AnastasiaMelnic/Rauch-Filter-and-PGA-Signal-Conditioning-Interface/Raport Proiect Practic CAIF.pdf

# Proiect CAIF

Tema: | Proiectarea unei interfețe analogice, formată dintr-un filtru Rauch trece – bandă de ordinul 2 și un amplificator programabil, în baza specificațiilor și topologiilor date
Student: | Melnic Anastasia

## 1. Specificații generale :

### 1.1 Schema bloc

În Figura 1 este reprezentată schema bloc a interfeței analogice proiectate.

Interfața analogică este un sistem care permite comunicarea între un dispozitiv digital (de ex. microcontroler) și lumea analogică (de ex. senzori). Aceasta:

- Primește sau transmite semnalele analogice;
- Le condiționează (filtrează, amplifică);
- Le pregătește pentru conversia în digital (printr-un ADC) sau invers (prin DAC);

Rolul elementelor din schema bloc (Figura 1):

- Senzorul măsoară o mărime fizică și o transformă într-un semnal electric analogic(tensiune).
- Filtrul trece-bandă elimină zgomotul și frecvențele nedorite din semnalul primit de la senzor. Păstrează o bandă specifică de frecvențe.
- Amplificatorul programabil amplifică semnalul analogic la un nivel optim pentru ADC, pentru a utiliza întreaga gamă a ADC-ului și a asigura o precizie mare a conversiei.
- ADC-ul convertește semnalul analogic, filtrat și amplificat, într-o valoare digitală.
Sensor | Rauch
BPF | PGA | ADC

Figura 1 Schema bloc

### 1.2 Specificații Etaj 1 (Filtru)

Tip funcție de transfer | Topologie | Câștigul linear în banda de trecere |H0| | Rintrare minim | Q | BW | Liniaritate
Trece-bandă | Rauch | 1 | 1 kΩ | 0.707 | 1 kHz | Amplitudinea de la ieșire = (amplitudinea Amplitudinea de iesire = (amplitudinea de de la intrare) * (câstigul în banda de trecere) pentru un semnal armonic cu frecvența = frecvența centrală

### 1.3 Specificații Etaj 2 (PGA)

Tip PGA | Castig minim | Rezolutie | Numar pasi | Castig maxim | Rin minim | Banda
Inversor, switch-uri in calea de semnal, conexiune serie | 8 dB | 3dB | 4 | 17 dB | 1 kΩ | Mai mare decat banda filtrului

Tabel 1 Specificații Etaj 1 (Filtru)

Tabel 2 Specificații Etaj 2 (PGA)

## 2. Dimensionarea circuitului

### 2.1 Dimensionare FTB Rauch

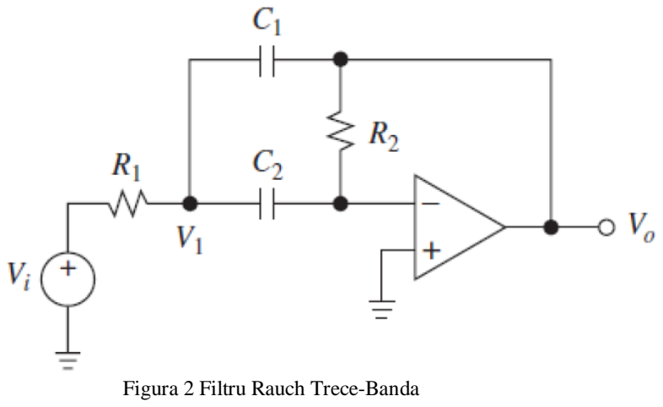
[picture p1: figure]
Figura 2 Filtru Rauch Trece-Banda

Formula funcției de transfer a filtrului este:

H(s) =

H0 ∙

ω0
Q
- s

s

2 +

ω0
Q
- s+ ω0

2

(1)

Pulsația centrală este:

ω0 =

1
√R1R2C1C2

(2)

Factorul de calitate este:

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
Câstigul la frecvența centrală este:

H0 =

−

R2
R1
1+

C1
C2

(4)

Consider C1=C2=C. Formulele (2), (3), (4) devin:

ω0 =

1
C ∙ √R1R2

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
H0 = −

R2
2R1

(7)

În formula (7), semnul “-“ din fața raportului indică faptul că semnalul de ieșire e în antifază față de semnalul de intrare. În continuare, pentru dimensionarea filtrului voi volosi |H0|.

Ținând cont că frecvența centrală f0 este:

f0 = BW ∙ Q | (8)

am determinat expresiile pentru dimensionarea rezistențelor:

R1 =

1
C

∙

1
2π ∙|H0

|∙BW

| (9)

R2 =

1
C

∙

1
π ∙BW | (10)

Pentru C=65 nF, am obținut R1=2448 Ω si R2=4897 Ω.
Am folosit în circuit amplificatorul operațional LT1357, pe care l-am alimentat cu ±5 V.

În Figura 3 e reprezentat circuitul in LTspice:

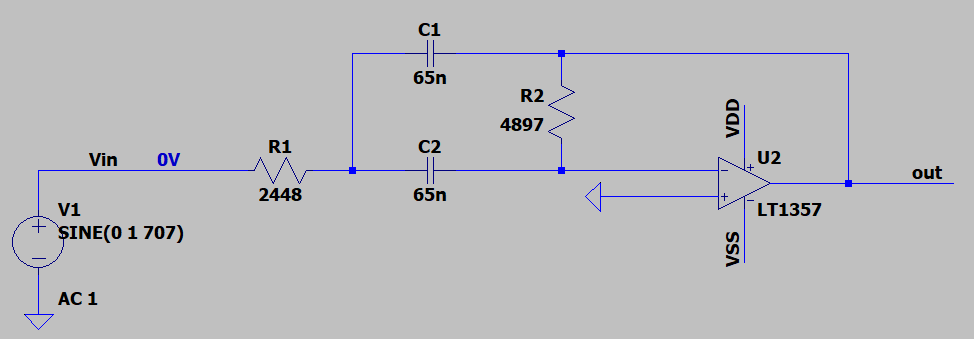
[picture p2: figure]

Pentru a asigura o implementare corectă a circuitului pe breadboard, am măsurat cu multimetrul valorile exacte ale rezistențelor. Capacitatea condensatorului am

Figura 3 Filtru Rauch Trece-Banda dimensionat determinat-o experimental, cu ajutorul unui filtru RC, și am observat că, deși condensatorul este marcat ca având o valoare nominală de 100nF, capacitatea efectivă masurată este de aproximativ 65nF, ceea ce indică o toleranță mare a componentelor.

Pentru a obține R1≈2.45kΩ, am conectat în serie 3 rezistențe de 2.2kΩ, 220Ω și 33Ω, iar pentru R2≈4.9kΩ, am conectat în serie 1 rezistență de 4.7 kΩ și 2 rezistențe de câte 150 Ω. Am folosit 2 condensatoare cu capacitatea nominală de 100nF (valoarea masurată este 65nF).
În Figura 4 este reprezentat montajul pe breadboard:

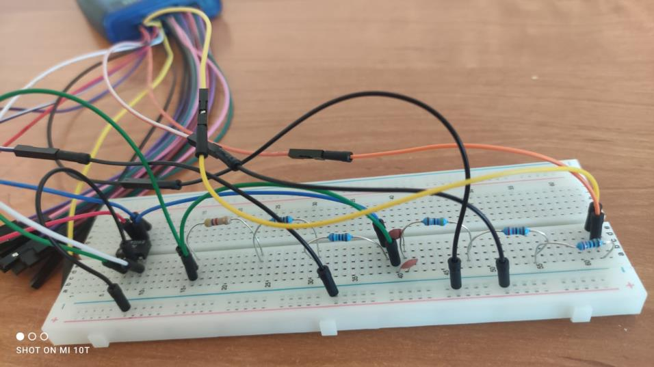
[picture p3: figure]

### 2.3 Dimensionare PGA

Conform specificatiilor, |Av| = {8dB, 11dB, 14dB, 17dB} = {2.51V/V, 3.54V/V, 5.01V/V, 7.07V/V}. Am dimensionat PGA-ul in baza formulelor:
|AV1| =

RF1
RG

= 2.51

|AV2| =

RF1 + RF2
RG

= 3.54

|AV3| =

RF1 + RF2 + RF3
RG

= 5.01

|AV4| =

RF1 + RF2 + RF3 + RF4
RG

= 7.07

Figura 4 Filtru Rauch Trece-Banda, montaj experimental

Am ales RG=1016Ω si am determinat RF1=2554Ω, RF2=1056Ω, RF3=1498Ω si RF4=2128Ω.

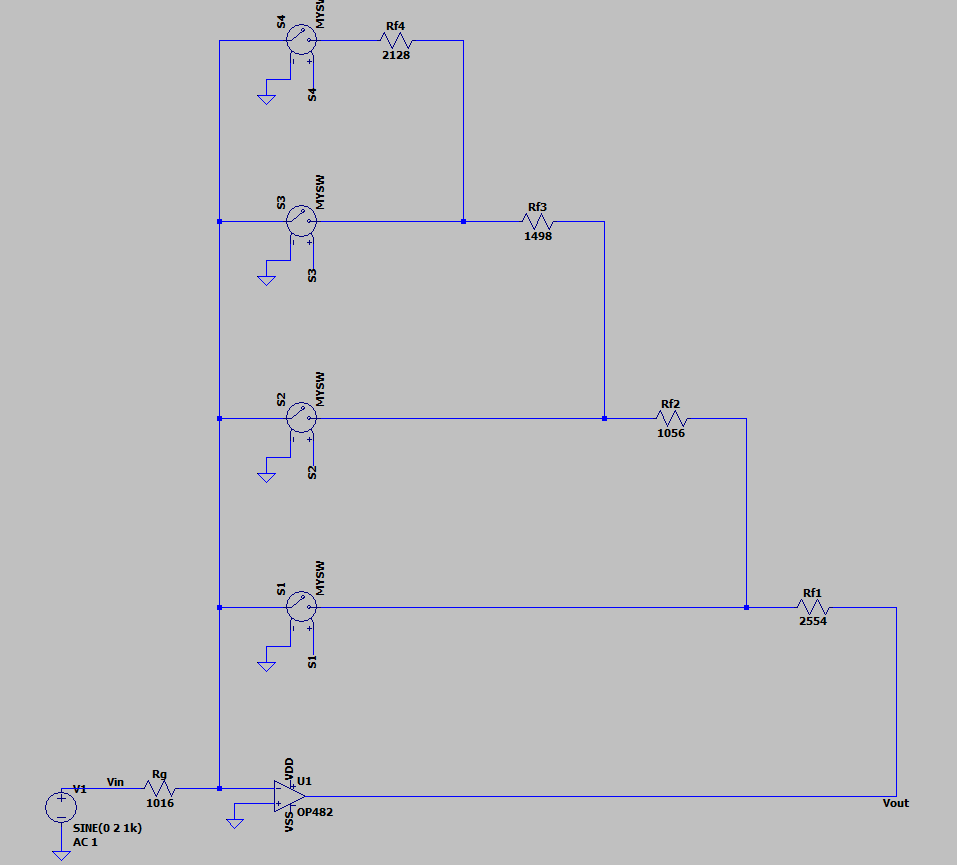
[picture p4: figure]

## 3 Verificarea și caracterizarea ansamblului FTB+PGA

3.1Verificarea și caracterizarea filtrului Rauch Trece-Banda prin simulari

Rezultatele analizei DCOP sunt reprezentate in Figura 5. Observăm că, V(out)≈0V, adică exact la mijlocul domeniului de alimentare. Prin urmare, semnalul de ieșire va putea oscila simetric în jurul acestui punct, fară a fi distorsionat. Curenții prin condensatori sunt practic nuli, deoarece, în regim DC, condensatorii se comportă ca întreruperi de circuit. Diferența de tensiune dintre bornele de intrare ale amplificatorului operațional este aproximativ nulă, ceea ce confirmă funcționarea AO-ului în regiunea liniară.

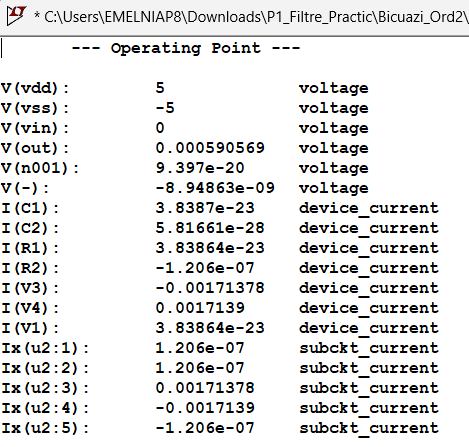
[picture p5: figure]

Pentru a determina domeniul tensiunii de intrare de mod comun, am conectat ambele intrări ale filtrului la o sursă de tensiune VDC, apoi am rulat o analiză DC Sweep în care am variat tensiunea generată de sursa respectivă între -5V și +5V. În Figura 6 este circuitul folosit pentru a măsura domeniul tensiunii de intrare de mod comun:

Figura 5 Punctul static de funcționare

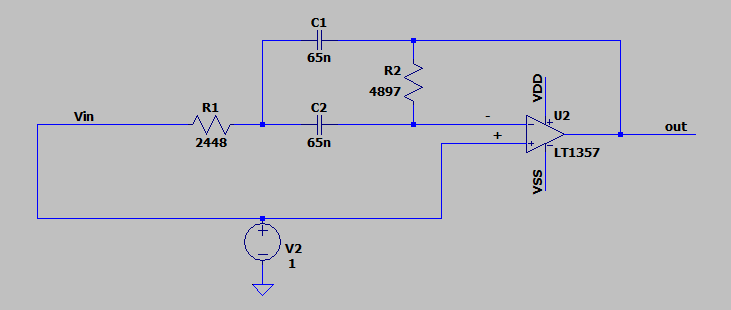
[picture p6: figure]

Figura 6 Configurație pentru determinarea domeniului tensiunii de intrare de mod comun

În Figura 7 sunt reprezentate rezultatele analizei DC Sweep. În graficul de sus este afișat V(out), iar în cel de jos |V(+) – V(-)|. Domeniul tensiunii de intrare de mod comun este intervalul pentru care AO-ul operează în regim linear, adică V(out) e proporțional cu tensiunea de intrare V2, iar |V(+) – V(-)| ≈ 0. În urma măsurătorilor, am obținut domeniul tensiunii de intrare de mod comun = [-3.3V ; +3.6V], ceea ce corespunde valorilor din datasheet-ul LT1357 ([-3.5V ; +3.5V]) pentru alimentarea la ±5V. Domeniul tensiunii de ieșire de mod comun corespunde domeniului tensiunii de intrare de mod comun.

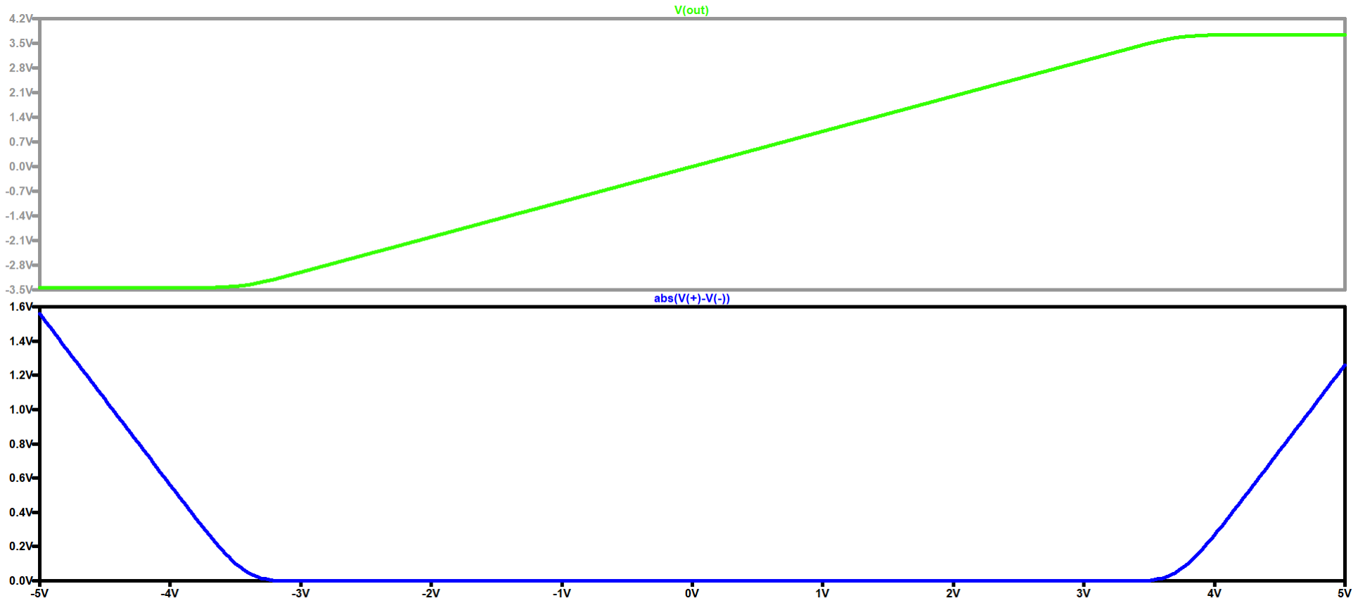
[picture p7: figure]

Consumul de curent al circuitului Itotal ≈ |I(V3)| + |I(V4)| ≈3.43mA.

Pentru a măsura banda de trecere a filtrului și câștigul în banda de trecere, am rulat o analiză AC și am afișat pe grafic V(out). Rezultatul simulării poate fi vizualizat în Figura 8. Am obținut |H0| = 1.5mdB la frecvența centrală și BW =999Hz, ceea ce corespunde specificațiilor.

Am determinat domeniul liniar al ieșirii (Output Swing) [-4.12V ; +4.12V], rulând analize transient pentru semnale de intrare de amplitudini diferite. Domeniul liniar al ieșirii definește tensiunea maximă pe care amplificatorul operațional o poate furniza la ieșire fără distorsiuni. În Figura 9 observăm că V(out) este distorsionat și limitat la ±4.12V.

Figura 7 DC Sweep pentru determinarea domeniului tensiunii de intrare de mod comun

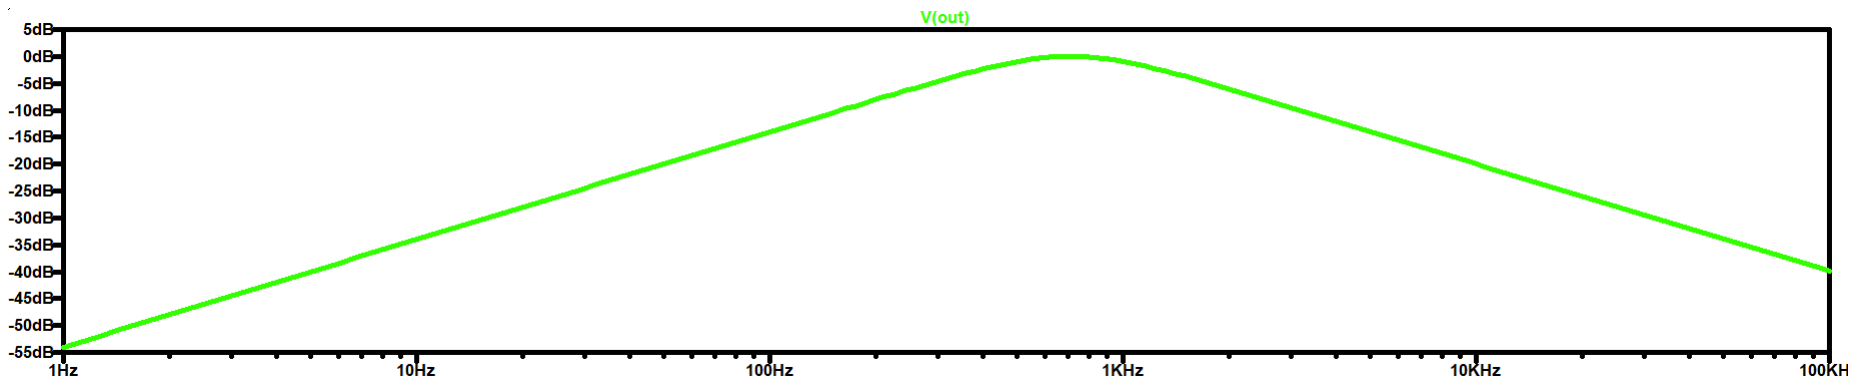
[picture p8: figure]
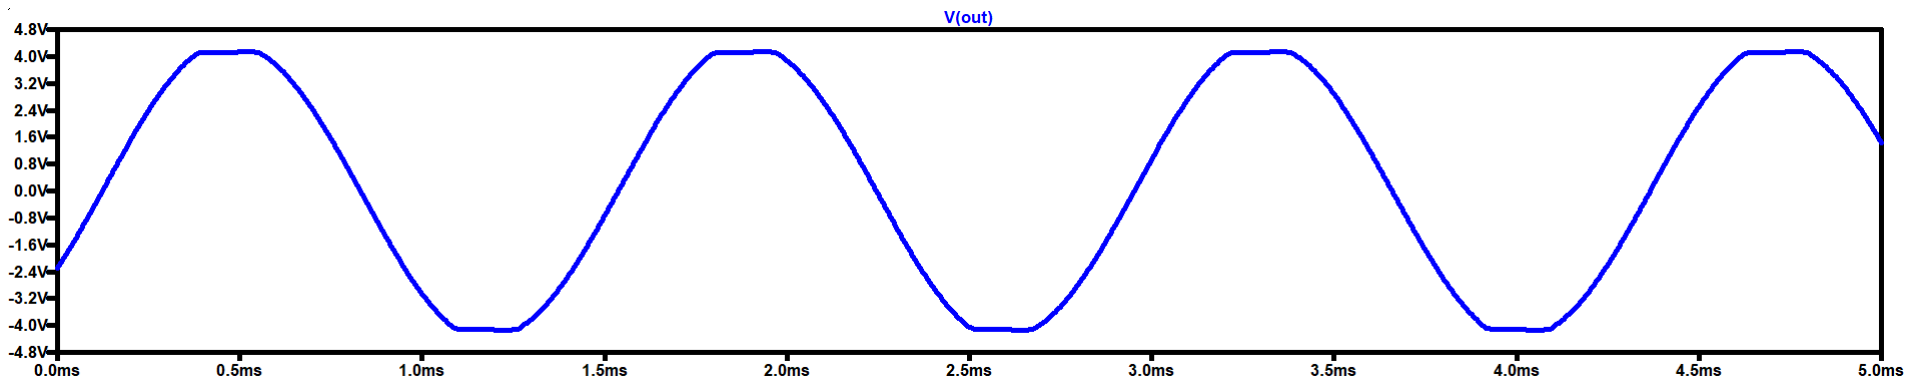
[picture p9: figure]

În Figura 10 este prezentat THD-ul pentru un semnal de intrare sinusoidal, cu amplitudinea 1V și frecvența 707Hz, iar în Figura 11 este ilustrat semnalul de ieșire corespunzător aceluiași semnal de intrare. Se poate observa că THD = 0%, iar V(out) păstrează amplitudinea de 1V, ceea ce confirmă că filtrul funcționeză în regim liniar.

Figura 8 AC Analysis pentru filtru Rauch Trece-Bandă

Figura 9 Limitarea semnalului de ieșire al FTB Rauch din cauza constrângerilor de output swing ale amplificatorului operațional

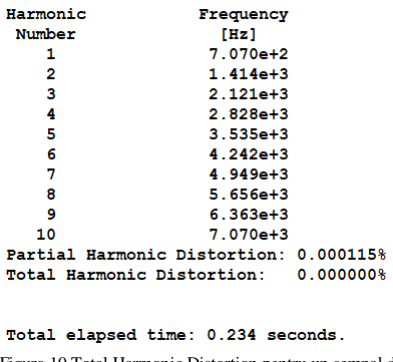
[picture p10: figure]

Figura 10 Total Harmonic Distortion pentru un semnal de intrare sinusoidal cu frecvența 707 Hz și amplitudinea 1V

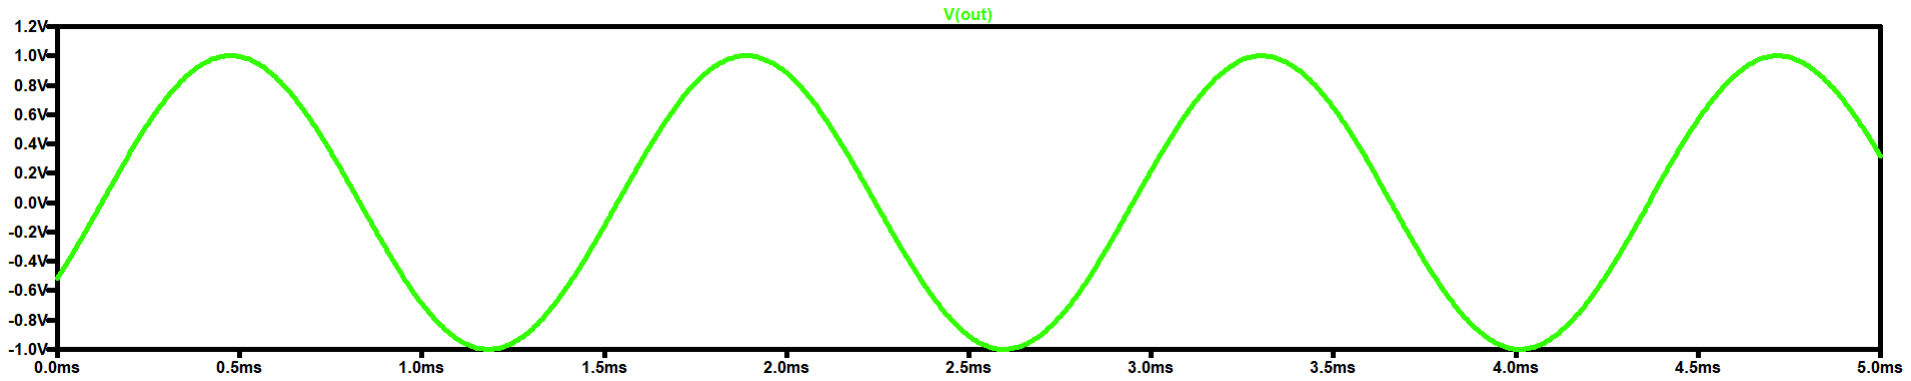
[picture p11: figure]

3.2Verificarea și caracterizarea filtrului Rauch Trece-Bandă prin masurători experimentale

Am verificat punctul static de funcționare (PSF), conectând intrarea filtrului la masă și măsurând cu osciloscopul din Scopy valorile tensiunilor și a curenților din circuit.
Am obținut tensiunea pozitivă de alimentare a amplificatorului operațional Vdd≈4.99V (Figura 12a), iar tensiunea negativă de alimentare a AO-ului, Vss≈-4.99V (Figura 12b). Tensiunea de intrare în circuit este Vin≈-2.27mV (Figura 12c), iar tensiunea de ieșire este Vout≈-24.15mV (Figura 12d). Tensiunile la bornele inversoare (Figura 12e) și neinversoare (Figura 12f) sunt V-≈-3.07mV și V+≈-1.81mV.
Curenții prin R1 și R2 sunt de ordinul pA.
Rezultatele obținute confirmă funcționarea corectă a circuitului în regim liniar. Abaterile minore de la valorile teoretice se datorează toleranțelor componentelor și zgomotului la măsurători, și nu afectează performanța dinamică a filtrului.

Figura 11 Semnalul de iesire din FTB Rauch, pentru un semnal de intrare sinusoidal cu frecvența 707 Hz și amplitudinea 1V

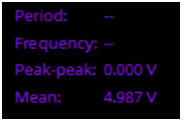
[picture p12: figure]
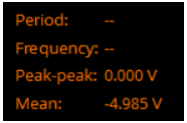
[picture p13: figure]

a) Vdd | b) Vss

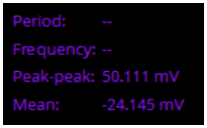
[picture p14: figure]
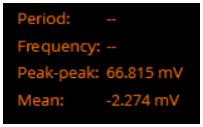
[picture p15: figure]
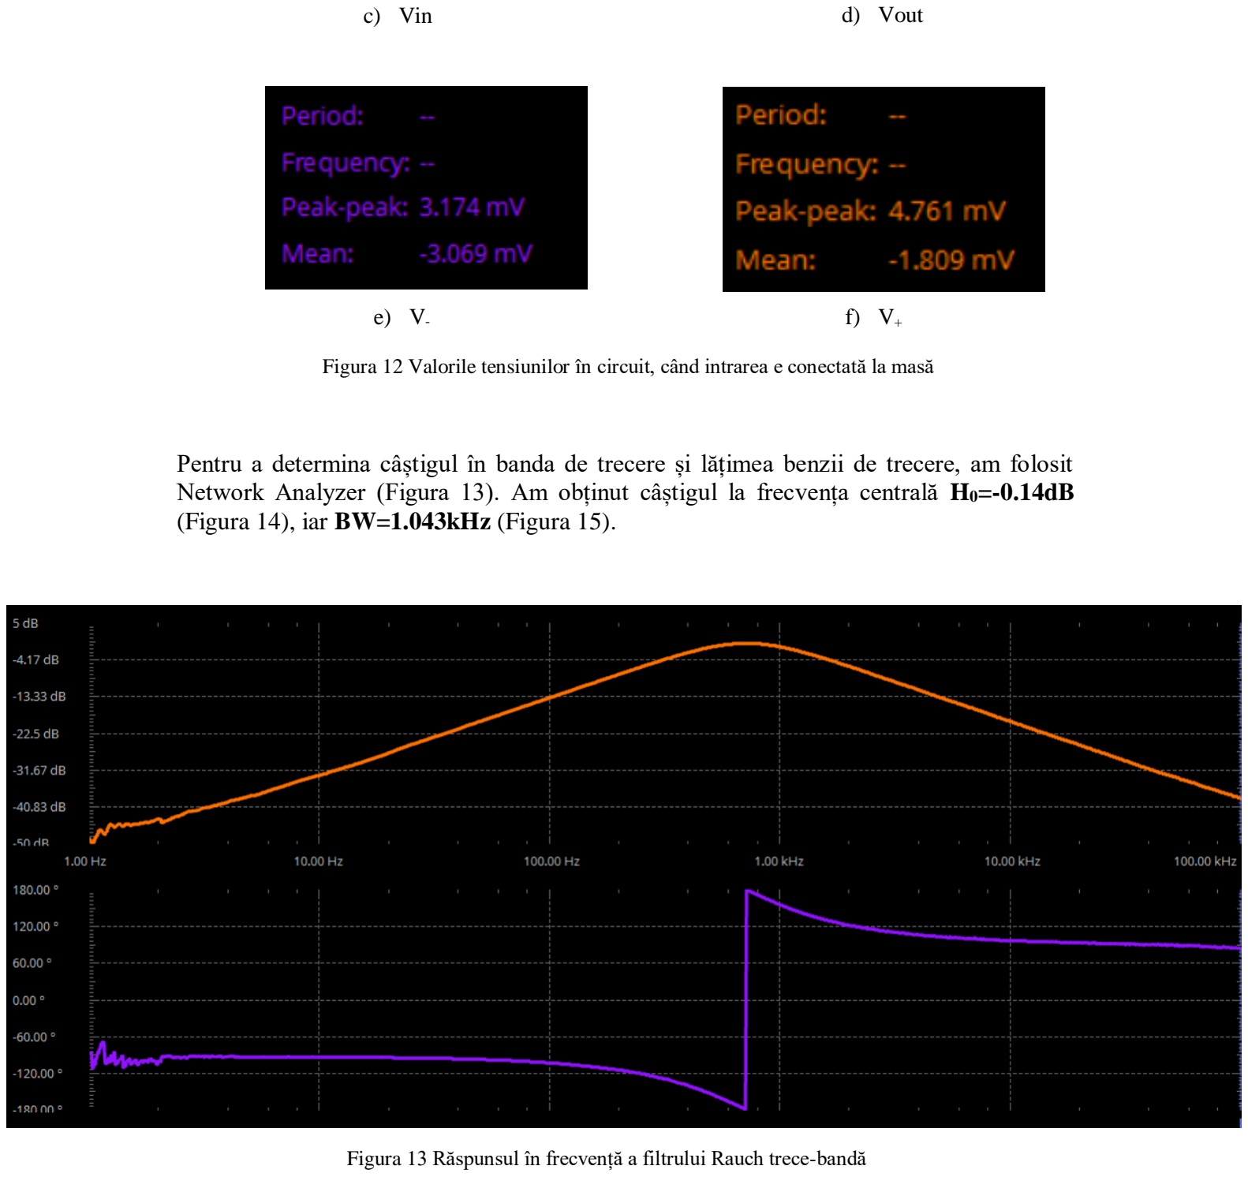
[picture p16: page 12]

Pentru a determina câștigul în banda de trecere și lățimea benzii de trecere, am folosit Network Analyzer (Figura 13). Am obținut câștigul la frecvența centrală H0=-0.14dB (Figura 14), iar BW=1.043kHz (Figura 15).

c) Vin | d) Vout
e) V- | f) V+

Figura 12 Valorile tensiunilor în circuit, când intrarea e conectată la masă

Figura 13 Răspunsul în frecvență a filtrului Rauch trece-bandă

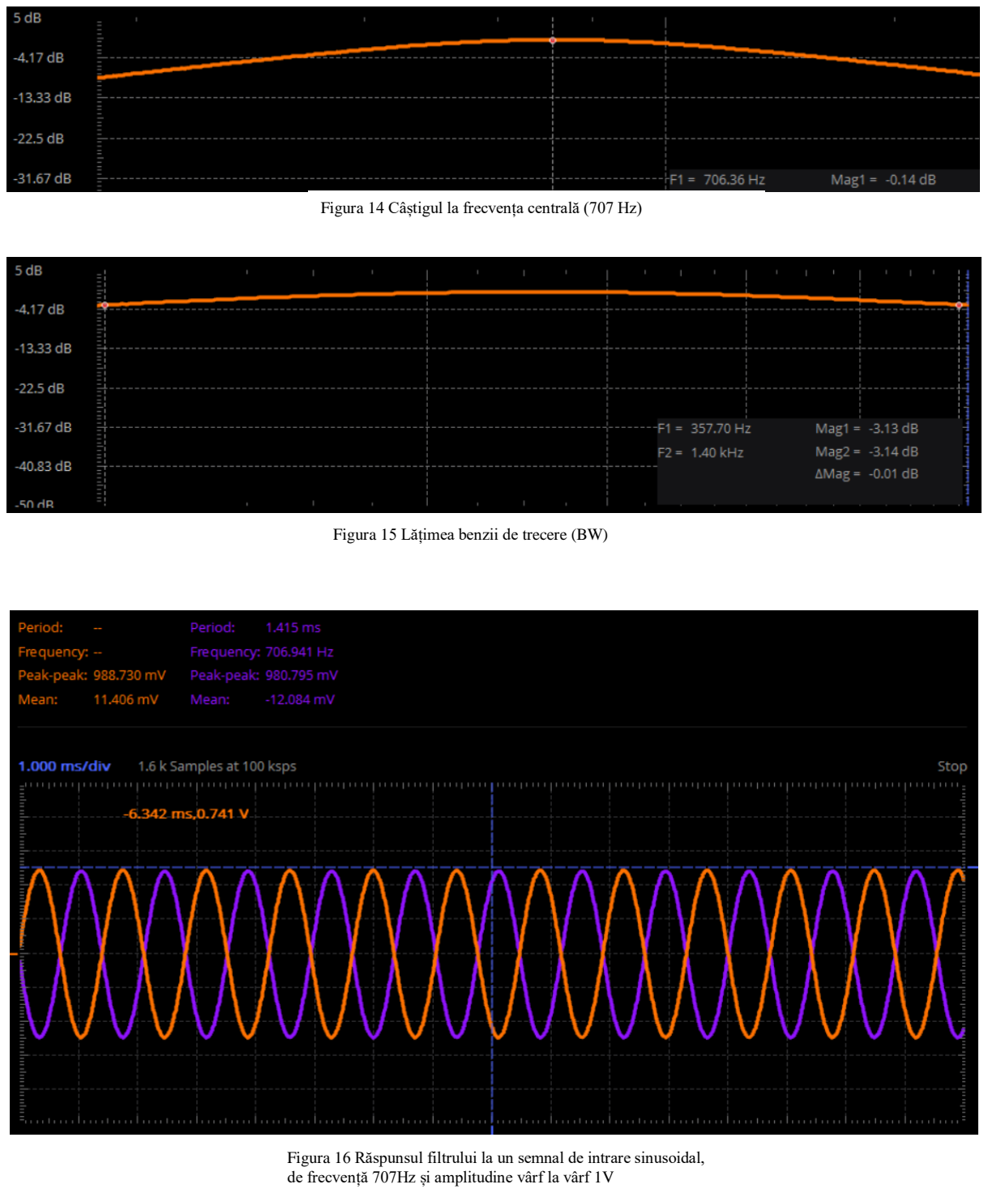
[picture p17: page 13]

În Figura 16 sunt reprezentate semnalul de intrare (oranj), de frecvență 707Hz, generat cu Signal Generator, și semnalul de ieșire (albastru) al filtrului.

Figura 14 Câștigul la frecvența centrală (707 Hz)

Figura 15 Lățimea benzii de trecere (BW)

Figura 16 Răspunsul filtrului la un semnal de intrare sinusoidal, de frecvență 707Hz și amplitudine vârf la vârf 1V

THD (Total Harmonic Distortion) măsoară cât de mult este distorsionat un semnal față de forma sa ideală. Am calulat THD-ul fitrului montat pe breadboard, în baza primelor 10 armonici, folosind formula (11):

### THD =

√V2RMS
2 | +V3RMS
2 | +V4RMS
2 | +V5RMS
2 | +V6RMS
2 | +V7RMS
2 | +V8RMS
2 | +V9RMS
2 | +V10RMS

2

V1RMS

Am măsurat valorile efective (RMS) ale armonicilor cu Spectrum Analyzer-ul din Scopy. Pentru o precizie maximă, am selectat Gain Mode = High, care e eficient pentru semnalele între -2.5V și +2.5V, și am folosit fereastra Flat Top, care asigură cea mai mare precizie în măsurarea amplitudinii, atât pentru armonica fundamentală, cât și pentru cele secundare. Rezultatul transformatei Fourier (FFT) este prezentat în Figura 17.

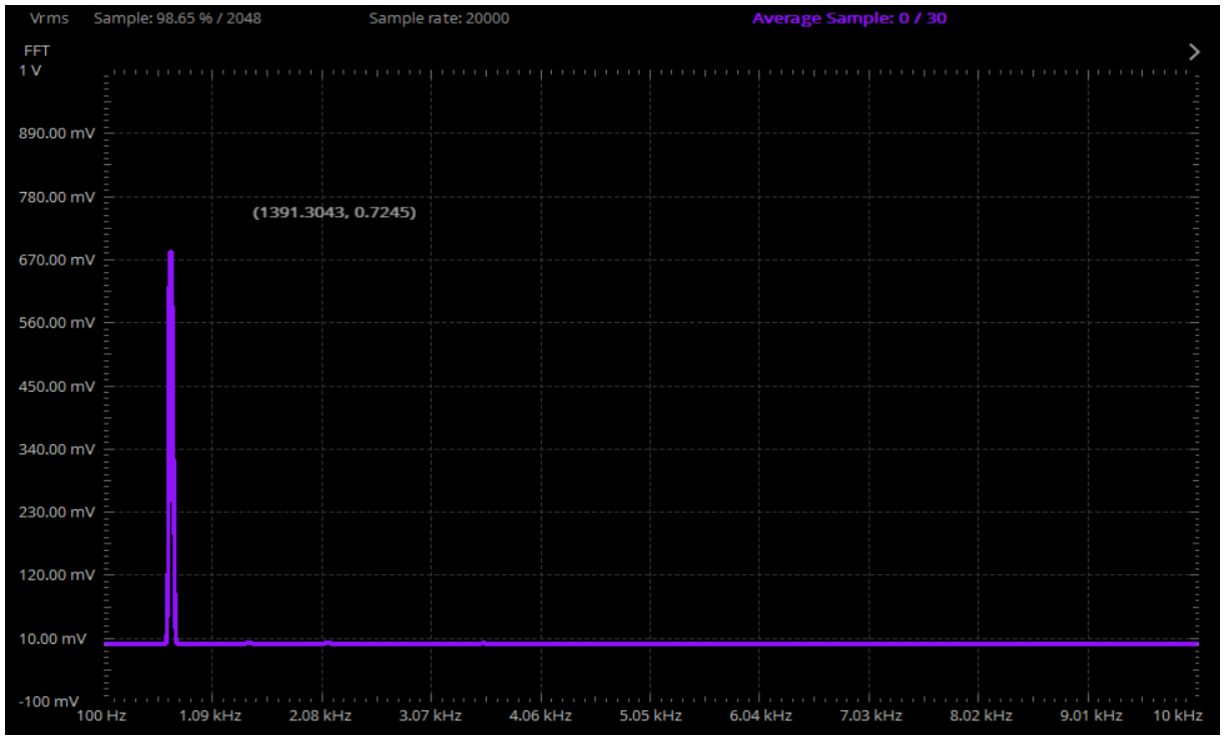
[picture p18: figure]

Figura 17 Spectrul semnalului de ieșire al filtrului

THD =

√0.00174² + 0.002055² + 0.000171² + 0.000345² + 0.000633² + 0.000186² + 0.000176² + 0.000237² + 0.00016²
0.684 | ∙ 100% = 0. 41%

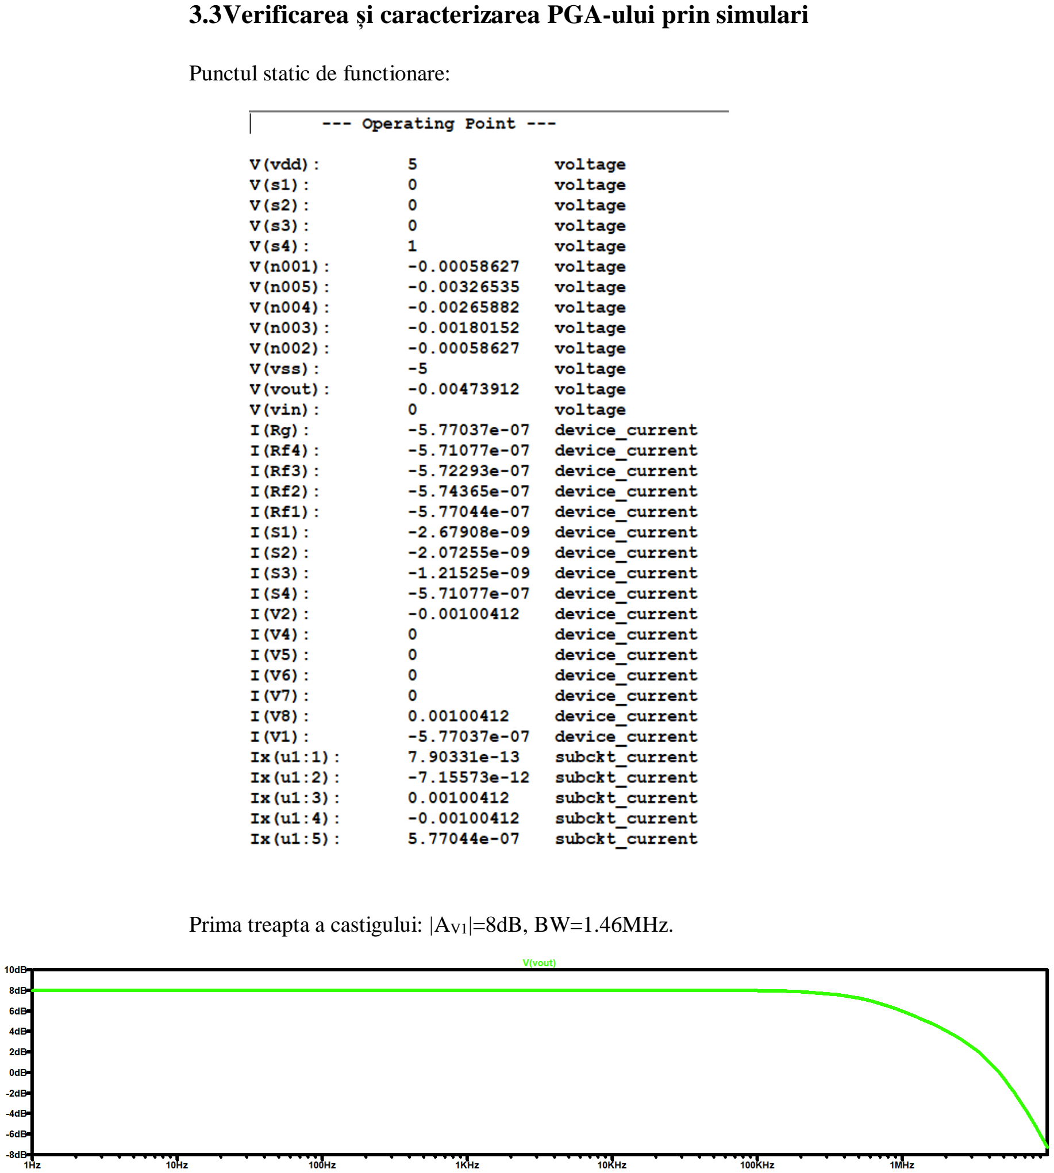
[picture p19: page 15]

3.3Verificarea și caracterizarea PGA-ului prin simulari

Punctul static de functionare:

Prima treapta a castigului: |AV1|=8dB, BW=1.46MHz.

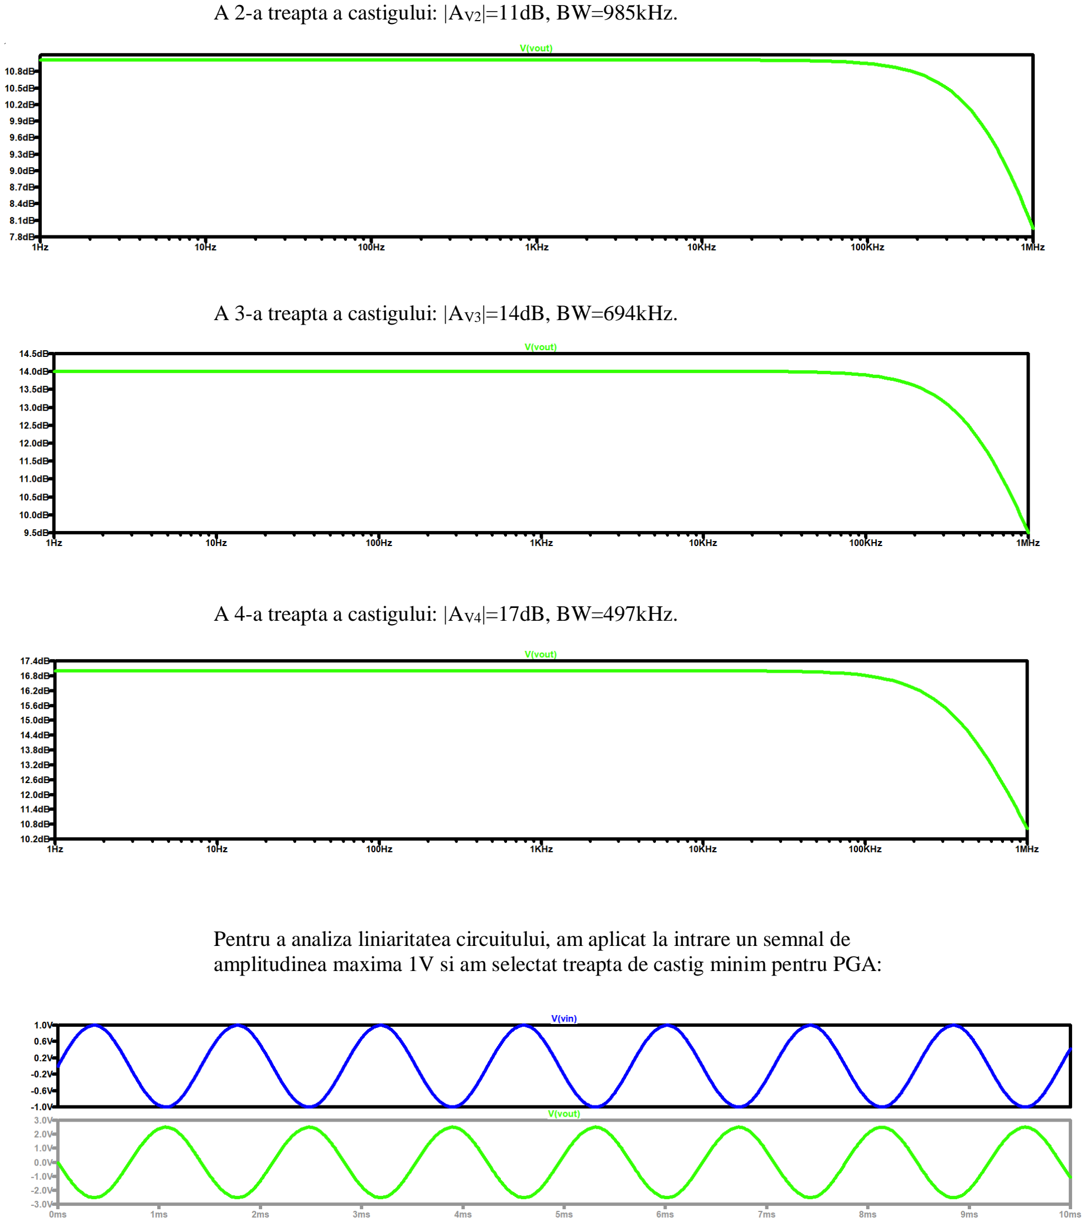
[picture p20: page 16]

A 2-a treapta a castigului: |AV2|=11dB, BW=985kHz.

A 3-a treapta a castigului: |AV3|=14dB, BW=694kHz.

A 4-a treapta a castigului: |AV4|=17dB, BW=497kHz.

Pentru a analiza liniaritatea circuitului, am aplicat la intrare un semnal de amplitudinea maxima 1V si am selectat treapta de castig minim pentru PGA:

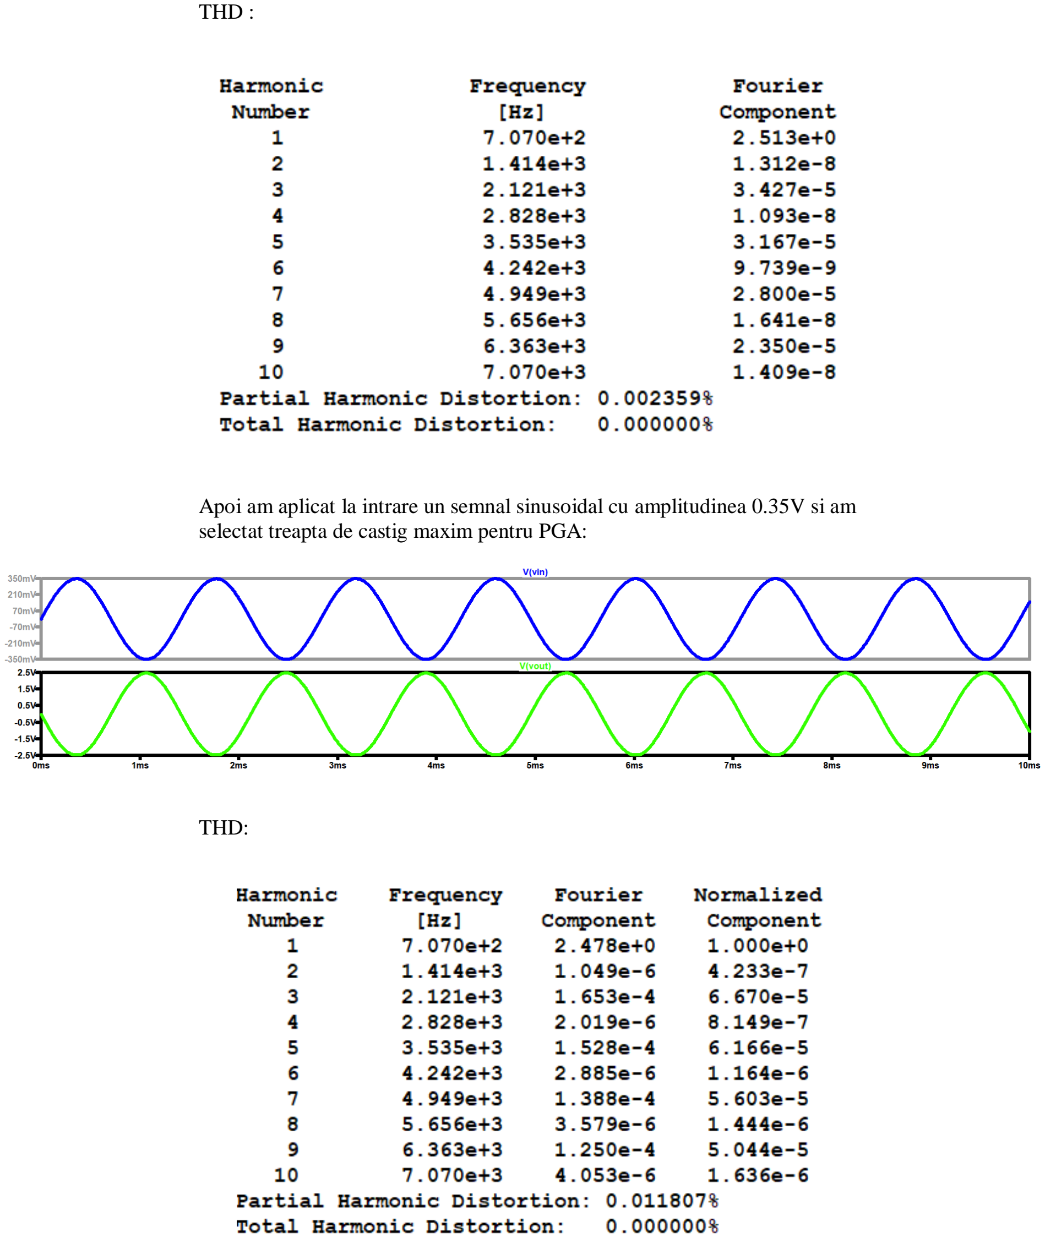
[picture p21: page 17]

THD :

Apoi am aplicat la intrare un semnal sinusoidal cu amplitudinea 0.35V si am selectat treapta de castig maxim pentru PGA:

THD:

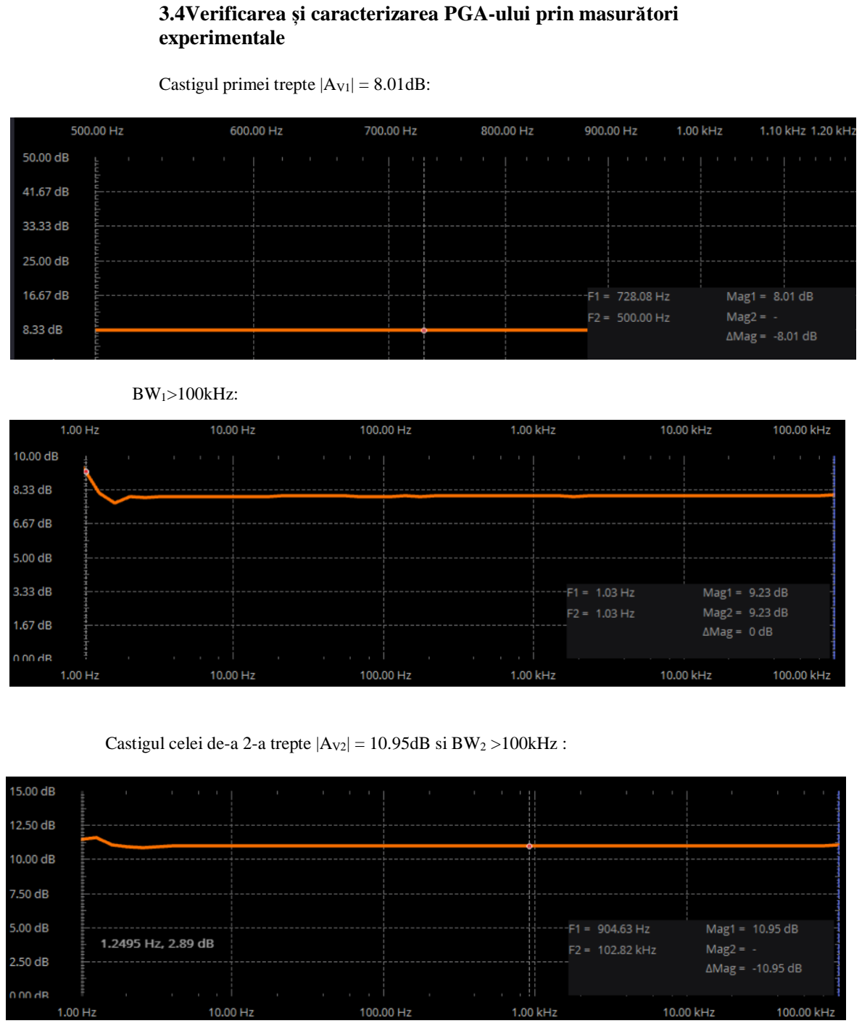
[picture p22: page 18]

3.4Verificarea și caracterizarea PGA-ului prin masurători experimentale

Castigul primei trepte |AV1| = 8.01dB:

BW1>100kHz:

Castigul celei de-a 2-a trepte |AV2| = 10.95dB si BW2 >100kHz :

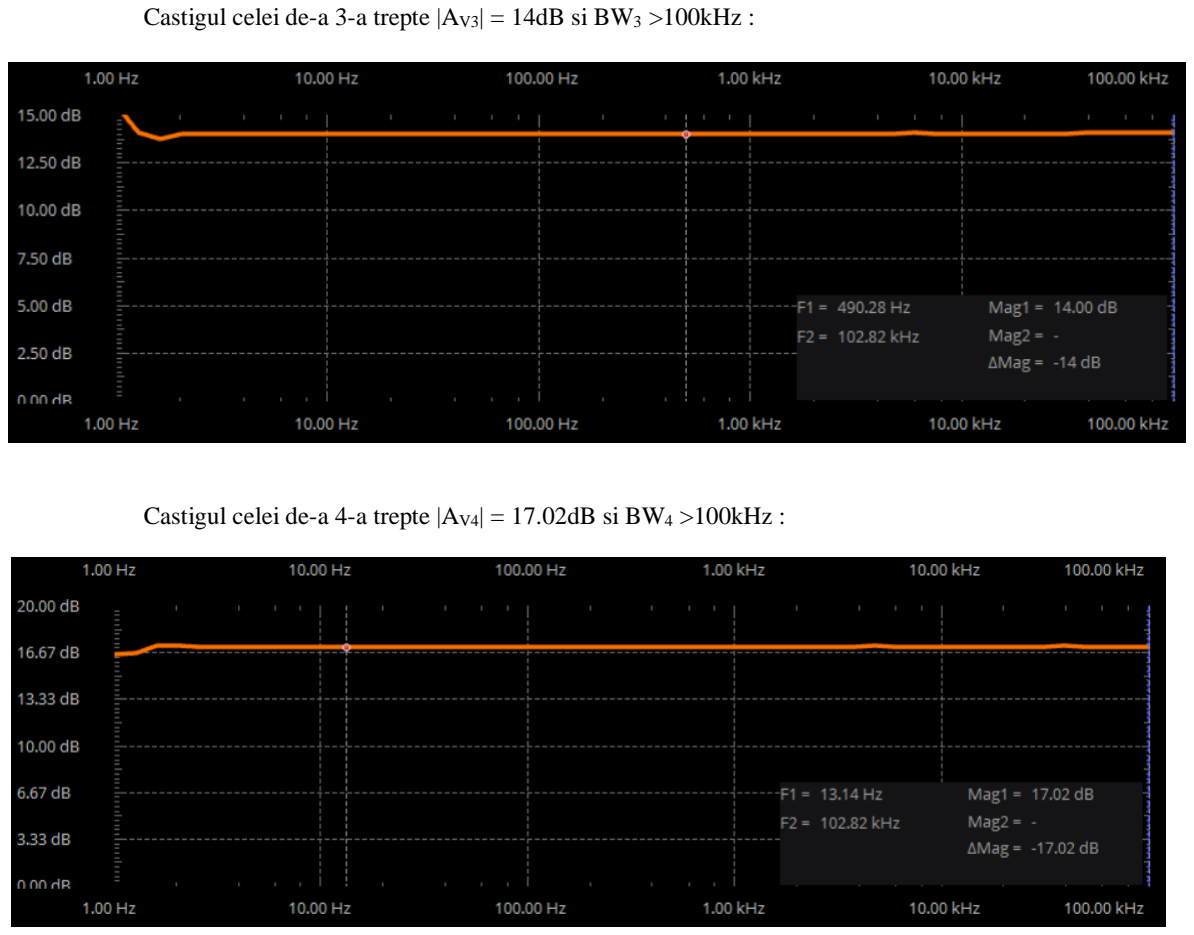
[picture p23: page 19]

Castigul celei de-a 3-a trepte |AV3| = 14dB si BW3 >100kHz :

## 3 Concluzii

Castigul celei de-a 4-a trepte |AV4| = 17.02dB si BW4 >100kHz :

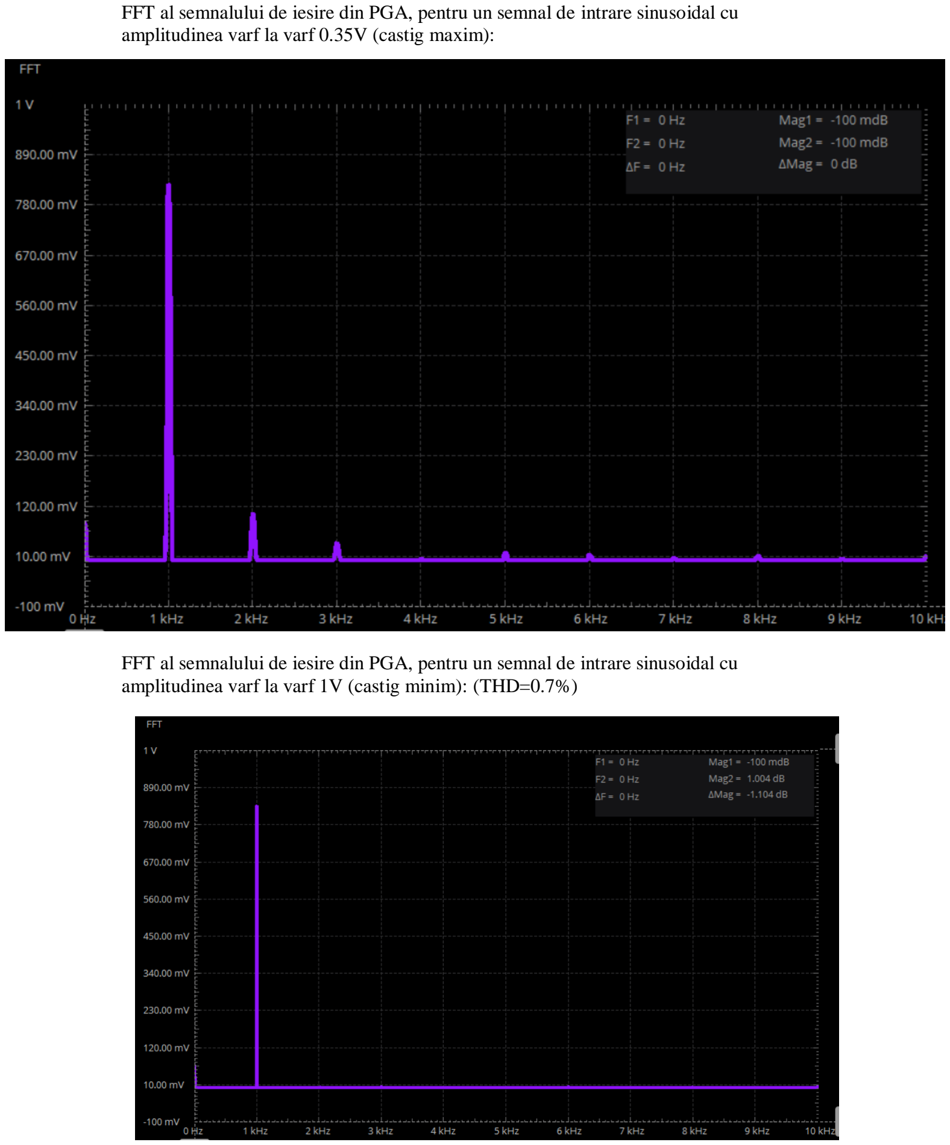
[picture p24: page 20]

FFT al semnalului de iesire din PGA, pentru un semnal de intrare sinusoidal cu amplitudinea varf la varf 0.35V (castig maxim):

FFT al semnalului de iesire din PGA, pentru un semnal de intrare sinusoidal cu amplitudinea varf la varf 1V (castig minim): (THD=0.7%)
