AnastasiaMelnic/Rauch-Filter-and-PGA-Signal-Conditioning-Interface/FTB_Rauch.asc

C1: cap; 65n
C2: cap; 65n
R1: res; 2448
R2: res; 4897
U1: OP482
V1: voltage; SINE(0 1 707); AC 1
V2: voltage; 1
V3: voltage; 5
V4: voltage; -5
Named nets: 0, VDD, VSS, out, Vin, -, +
.ac dec 1000 1 100k
.op
.dc V2 -5 +5 0.1
.FOUR 707hz 10 V(OUT)
.OPTIONS plotwinsize=0
To disable compression
.OPTIONS numdgt=7
.dc V2 -5 +5 0.1
.tran 0 7m 2m
