AnastasiaMelnic/Rauch-Filter-and-PGA-Signal-Conditioning-Interface/PGA_inversor_4trepte.asc

Rf1: res; 2554
Rf2: res; 1056
Rf3: res; 1498
Rf4: res; 2128
Rg: res; 1016
S1: sw; MYSW
S2: sw; MYSW
S3: sw; MYSW
S4: sw; MYSW
U1: OP482
V1: voltage; SINE(0 1 707); AC 1
V2: voltage; 5
V4: voltage; 1
V5: voltage; 0
V6: voltage; 0
V7: voltage; 0
V8: voltage; -5
Named nets: 0, VDD, S1, S2, S3, S4, VSS, Vin, Vout
.ac dec 100 1 1Meg
.op
.tran 10m
.OPTIONS plotwinsize=0
To disable compression
.OPTIONS numdgt=7
To switch to double precision math
on dependent variables
.meas AC Rin FIND Rintrare() AT 1
.func Rintrare() V(in)/I(Vin)
.FOUR 707 10 V(Vout)
.OPTIONS plotwinsize=0
To disable compression
.dc V1 0 1.8 1m
.model MYSW SW(Ron=1m Roff=1Meg Vt=0.5 Vh=0))
